elral/PCB_MF_PicoNano/piconano.kicad_pcb

## KiCad design piconano.kicad_pcb (2026-02-16)

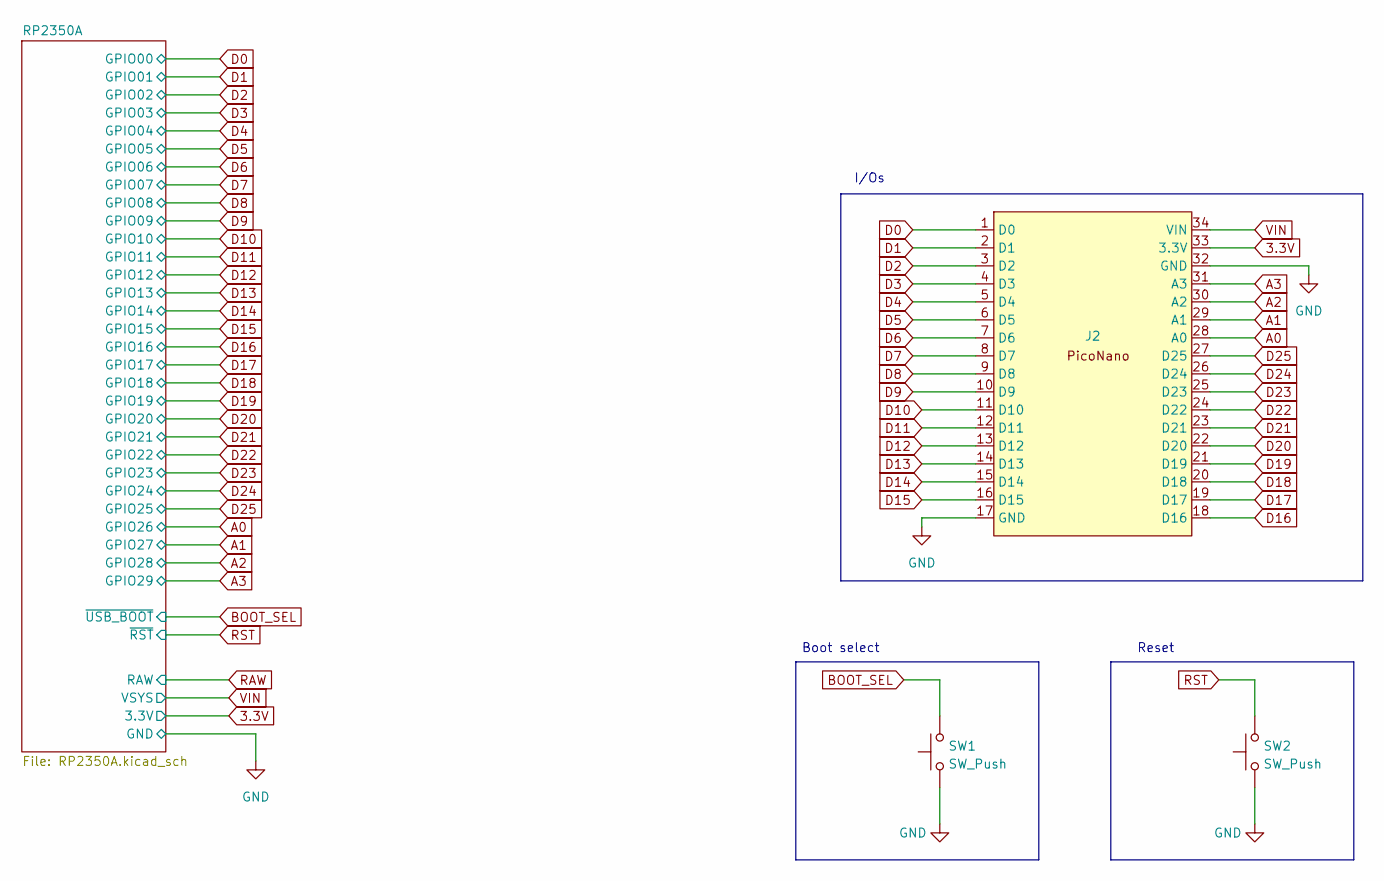
[picture p5: schematic piconano.kicad_sch, RP2350A Template]

Parts:
J2: PicoNano
SW1, SW2: SW_Push; SW_Push_1P1T_NO_Vertical_Wuerth_434133025816; LCSC C92589

Connections:
3.3V: J2.33 (3.3V); also elsewhere on the board
A0: J2.28 (A0); also elsewhere on the board
A1: J2.29 (A1); also elsewhere on the board
A2: J2.30 (A2); also elsewhere on the board
A3: J2.31 (A3); also elsewhere on the board
BOOT_SEL: SW1.2; also elsewhere on the board
D0: J2.1 (D0); also elsewhere on the board
D1: J2.2 (D1); also elsewhere on the board
D2: J2.3 (D2); also elsewhere on the board
D3: J2.4 (D3); also elsewhere on the board
D4: J2.5 (D4); also elsewhere on the board
D5: J2.6 (D5); also elsewhere on the board
D6: J2.7 (D6); also elsewhere on the board
D7: J2.8 (D7); also elsewhere on the board
D8: J2.9 (D8); also elsewhere on the board
D9: J2.10 (D9); also elsewhere on the board
D10: J2.11 (D10); also elsewhere on the board
D11: J2.12 (D11); also elsewhere on the board
D12: J2.13 (D12); also elsewhere on the board
D13: J2.14 (D13); also elsewhere on the board
D14: J2.15 (D14); also elsewhere on the board
D15: J2.16 (D15); also elsewhere on the board
D16: J2.18 (D16); also elsewhere on the board
D17: J2.19 (D17); also elsewhere on the board
D18: J2.20 (D18); also elsewhere on the board
D19: J2.21 (D19); also elsewhere on the board
D20: J2.22 (D20); also elsewhere on the board
D21: J2.23 (D21); also elsewhere on the board
D22: J2.24 (D22); also elsewhere on the board
D23: J2.25 (D23); also elsewhere on the board
D24: J2.26 (D24); also elsewhere on the board
D25: J2.27 (D25); also elsewhere on the board
GND: J2.17 (GND), J2.32 (GND), SW1.1, SW2.1; also elsewhere on the board
RST: SW2.2; also elsewhere on the board
VIN: J2.34 (VIN); also elsewhere on the board

Notes on the sheet:
Reset
Boot select
I/Os

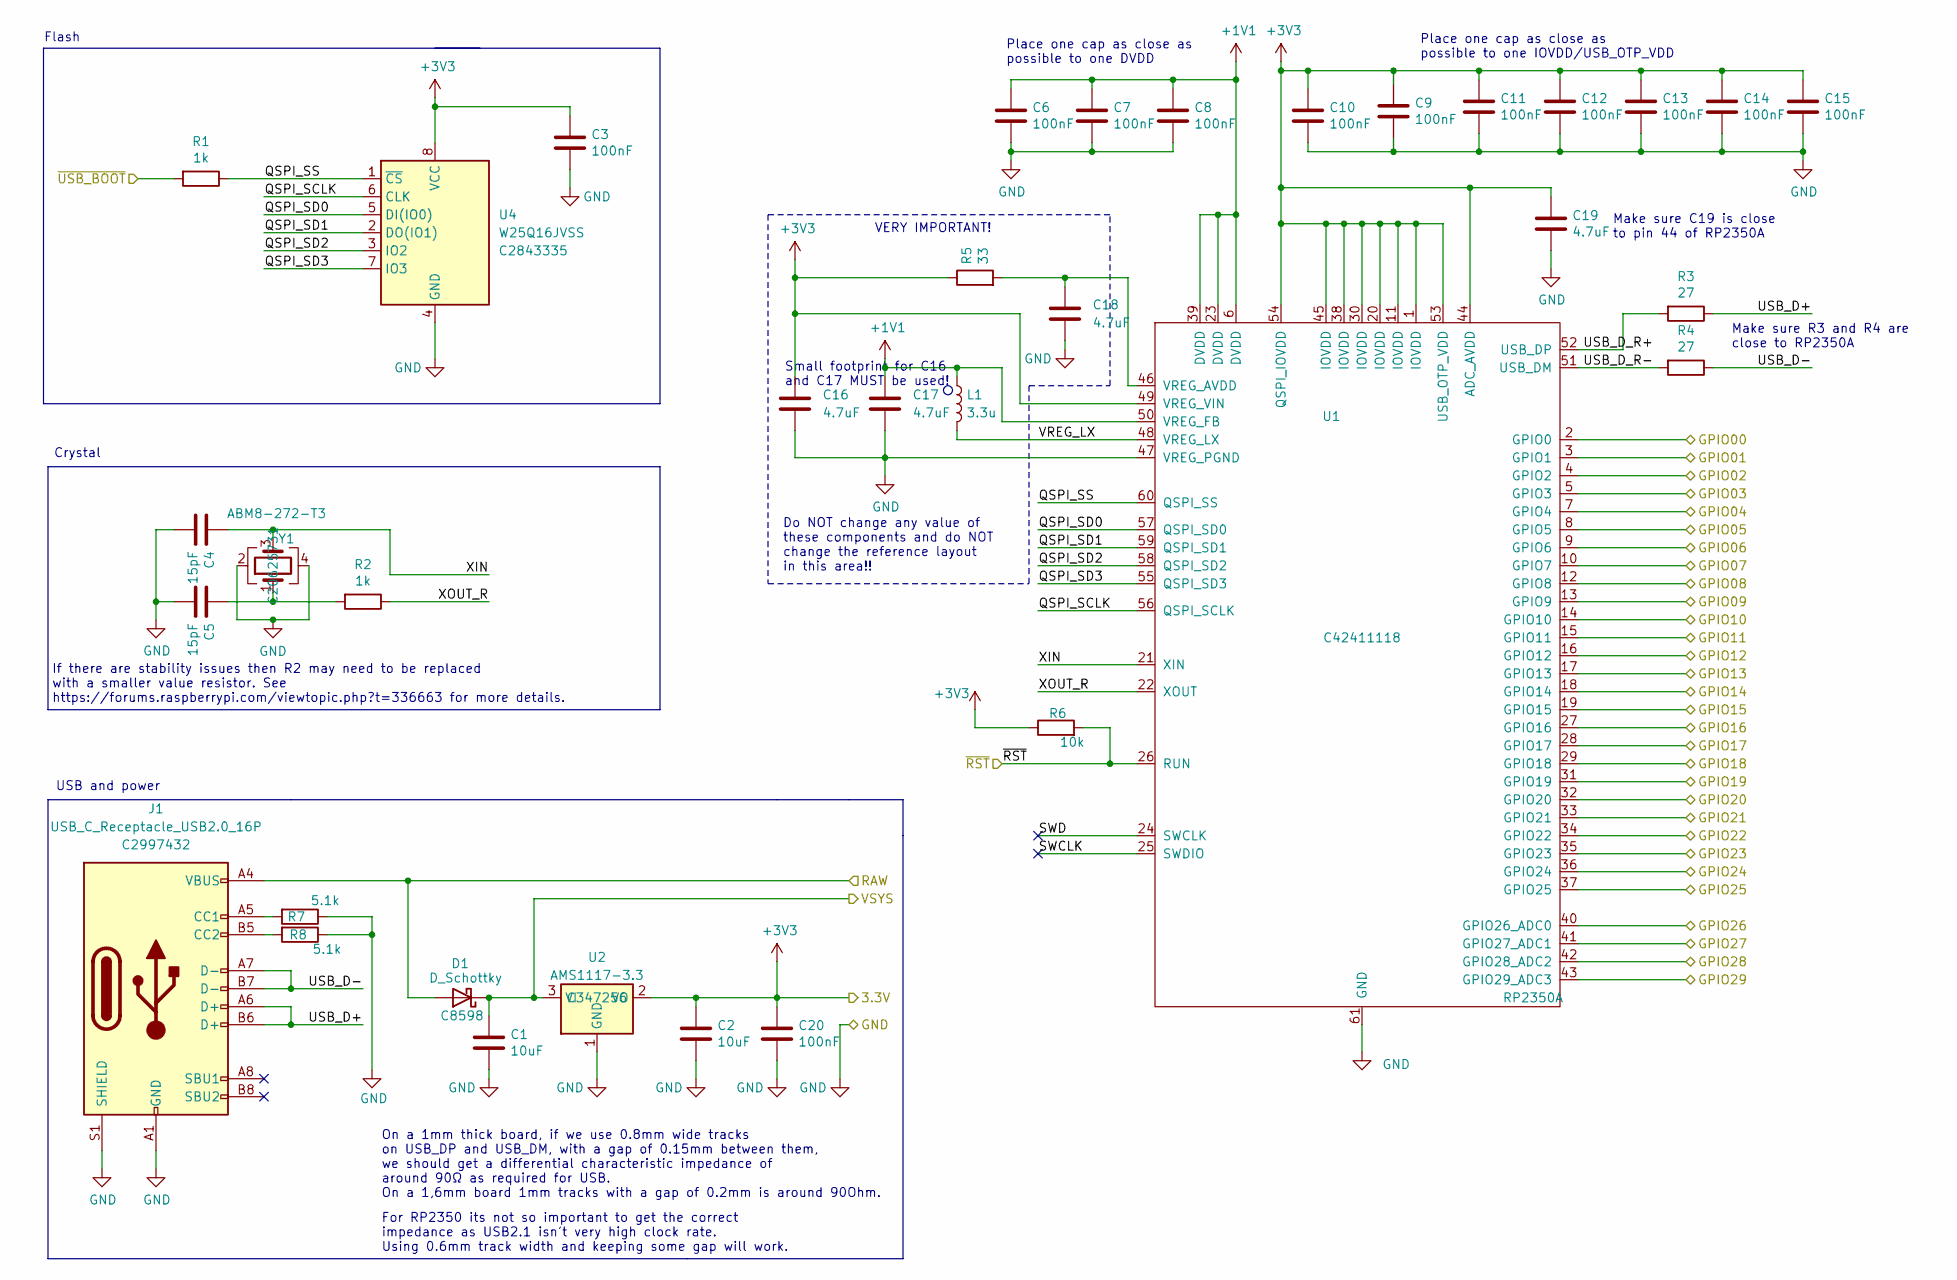
[picture p6: schematic RP2350A.kicad_sch, RP2350A Template]

Parts:
C1, C2: 10uF; C_0402_1005Metric; LCSC C15525
C3, C6, C7, C8, C9, C10, C11, C12, C13, C14, C15, C20: 100nF; C_0402_1005Metric; LCSC C1525
C4, C5: 15pF; C_0402_1005Metric; LCSC C1548
C16, C17: 4.7uF; C_0402_1005Metric_small_pads; LCSC C23733
C18, C19: 4.7uF; C_0402_1005Metric; LCSC C23733
D1: D_Schottky; D_SOD-123; LCSC C8598
J1: USB_C_Receptacle_USB2.0_16P; USB_C_Receptacle_HCTL_HC-TYPE-C-16P-01A; LCSC C2997432
L1: 3.3u; L_pol_2016; LCSC C42411119
R1, R2: 1k; R_0402_1005Metric; LCSC C11702
R3, R4: 27; R_0402_1005Metric; LCSC C25100
R5: 33; R_0402_1005Metric; LCSC C25105
R6: 10k; R_0402_1005Metric; LCSC C25744
R7, R8: 5.1k; R_0402_1005Metric; LCSC C25905
U1: RP2350A; RP2350A_QFN-60_EP_7.75x7.75_Pitch0.4mm; LCSC C42411118
U2: AMS1117-3.3; SOT-89-3; LCSC C347256
U4: W25Q16JVSS; Winbond_USON-8-1EP_3x2mm_P0.5mm_EP0.2x1.6mm; LCSC C2843335
Y1: ABM8-272-T3; Crystal_SMD_3225-4Pin_3.2x2.5mm; LCSC C20625731

Connections:
3.3V: C2.1, C3.1, C9.1, C10.1, C11.1, C12.1, C13.1, C14.1, C15.1, C16.1, C19.1, C20.1, R5.1, R6.1, U1.1 (IOVDD), U1.11 (IOVDD), U1.20 (IOVDD), U1.30 (IOVDD), U1.38 (IOVDD), U1.44 (ADC_AVDD), U1.45 (IOVDD), U1.49 (VREG_VIN), U1.53 (USB_OTP_VDD), U1.54 (QSPI_IOVDD), U2.2 (VO), U4.8 (VCC); also elsewhere on the board
+1V1: C6.1, C7.1, C8.1, C17.1, L1.1, U1.6 (DVDD), U1.23 (DVDD), U1.39 (DVDD), U1.50 (VREG_FB)
/RP2350A/QSPI_SCLK: U1.56 (QSPI_SCLK), U4.6 (CLK)
/RP2350A/QSPI_SD0: U1.57 (QSPI_SD0), U4.5 (DI(IO0))
/RP2350A/QSPI_SD1: U1.59 (QSPI_SD1), U4.2 (DO(IO1))
/RP2350A/QSPI_SD2: U1.58 (QSPI_SD2), U4.3 (IO2)
/RP2350A/QSPI_SD3: U1.55 (QSPI_SD3), U4.7 (IO3)
/RP2350A/QSPI_SS: R1.1, U1.60 (QSPI_SS), U4.1 (~CS)
/RP2350A/SWCLK: U1.25 (SWDIO)
/RP2350A/SWD: U1.24 (SWCLK)
/RP2350A/USB_D+: J1.A6 (D+), J1.B6 (D+), R3.1
/RP2350A/USB_D-: J1.A7 (D-), J1.B7 (D-), R4.1
/RP2350A/USB_D_R+: R3.2, U1.52 (USB_DP)
/RP2350A/USB_D_R-: R4.2, U1.51 (USB_DM)
/RP2350A/VREG_LX: L1.2, U1.48 (VREG_LX)
/RP2350A/XIN: C4.1, U1.21 (XIN), Y1.3
/RP2350A/XOUT_R: R2.1, U1.22 (XOUT)
A0: U1.40 (GPIO26_ADC0); also elsewhere on the board
A1: U1.41 (GPIO27_ADC1); also elsewhere on the board
A2: U1.42 (GPIO28_ADC2); also elsewhere on the board
A3: U1.43 (GPIO29_ADC3); also elsewhere on the board
BOOT_SEL: R1.2; also elsewhere on the board
D0: U1.2 (GPIO0); also elsewhere on the board
D1: U1.3 (GPIO1); also elsewhere on the board
D2: U1.4 (GPIO2); also elsewhere on the board
D3: U1.5 (GPIO3); also elsewhere on the board
D4: U1.7 (GPIO4); also elsewhere on the board
D5: U1.8 (GPIO5); also elsewhere on the board
D6: U1.9 (GPIO6); also elsewhere on the board
D7: U1.10 (GPIO7); also elsewhere on the board
D8: U1.12 (GPIO8); also elsewhere on the board
D9: U1.13 (GPIO9); also elsewhere on the board
D10: U1.14 (GPIO10); also elsewhere on the board
D11: U1.15 (GPIO11); also elsewhere on the board
D12: U1.16 (GPIO12); also elsewhere on the board
D13: U1.17 (GPIO13); also elsewhere on the board
D14: U1.18 (GPIO14); also elsewhere on the board
D15: U1.19 (GPIO15); also elsewhere on the board
D16: U1.27 (GPIO16); also elsewhere on the board
D17: U1.28 (GPIO17); also elsewhere on the board
D18: U1.29 (GPIO18); also elsewhere on the board
D19: U1.31 (GPIO19); also elsewhere on the board
D20: U1.32 (GPIO20); also elsewhere on the board
D21: U1.33 (GPIO21); also elsewhere on the board
D22: U1.34 (GPIO22); also elsewhere on the board
D23: U1.35 (GPIO23); also elsewhere on the board
D24: U1.36 (GPIO24); also elsewhere on the board
D25: U1.37 (GPIO25); also elsewhere on the board
GND: C1.2, C2.2, C3.2, C4.2, C5.2, C6.2, C7.2, C8.2, C9.2, C10.2, C11.2, C12.2, C13.2, C14.2, C15.2, C16.2, C17.2, C18.2, C19.2, C20.2, J1.A1 (GND), J1.A12 (GND), J1.B1 (GND), J1.B12 (GND), J1.S1 (SHIELD), R7.1, R8.1, U1.47 (VREG_PGND), U1.61 (GND), U2.1 (GND), U4.4 (GND), Y1.2, Y1.4; also elsewhere on the board
unnamed: C5.1, R2.2, Y1.1
unnamed: J1.A5 (CC1), R7.2
unnamed: J1.B5 (CC2), R8.2
unnamed: C18.1, R5.2, U1.46 (VREG_AVDD)
RAW: D1.2 (A), J1.A4 (VBUS), J1.A9 (VBUS), J1.B4 (VBUS), J1.B9 (VBUS)
RST: R6.2, U1.26 (RUN); also elsewhere on the board
VIN: C1.1, D1.1 (K), U2.3 (VI); also elsewhere on the board

Notes on the sheet:
USB and power
Small footprint for C16 and C17 MUST be used!
If there are stability issues then R2 may need to be replaced with a smaller value resistor. See https://forums.raspberrypi.com/viewtopic.php?t=336663 for more details.
Make sure R3 and R4 are close to RP2350A
Crystal
Make sure C19 is close to pin 44 of RP2350A
On a 1mm thick board, if we use 0.8mm wide tracks on USB_DP and USB_DM, with a gap of 0.15mm between them, we should get a differential characteristic impedance of around 90Ω as required for USB. On a 1,6mm board 1mm tracks with a gap of 0.2mm is around 90Ohm.
Place one cap as close as possible to one IOVDD/USB_OTP_VDD
For RP2350 its not so important to get the correct impedance as USB2.1 isn't very high clock rate. Using 0.6mm track width and keeping some gap will work.
VERY IMPORTANT!
Flash
Place one cap as close as possible to one DVDD
Do NOT change any value of these components and do NOT change the reference layout in this area!!

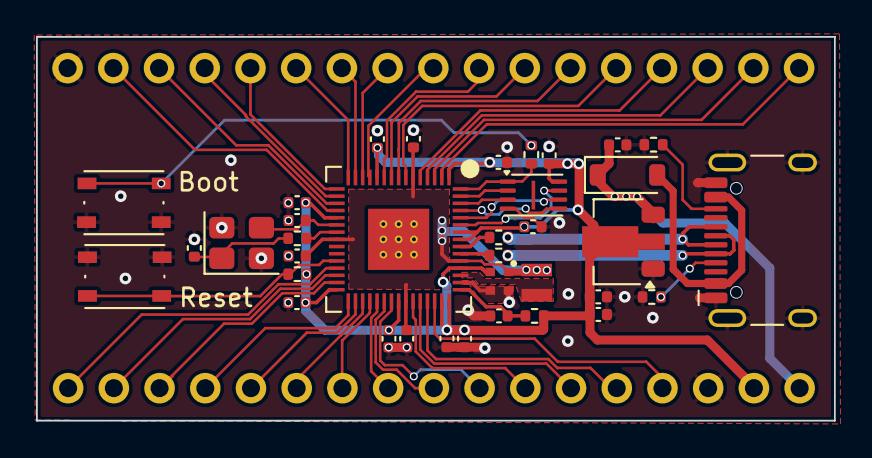
[picture p7: board piconano.kicad_pcb from above]

Board: 2 copper layers, 44.3 x 21.3 mm, 38 parts (0 on the bottom side), 54 nets.
